jwhitham/towel-rail-system/tr/tr.kicad_pcb

## KiCad design PCB/electrical_integration/motor_driver.kicad_sch

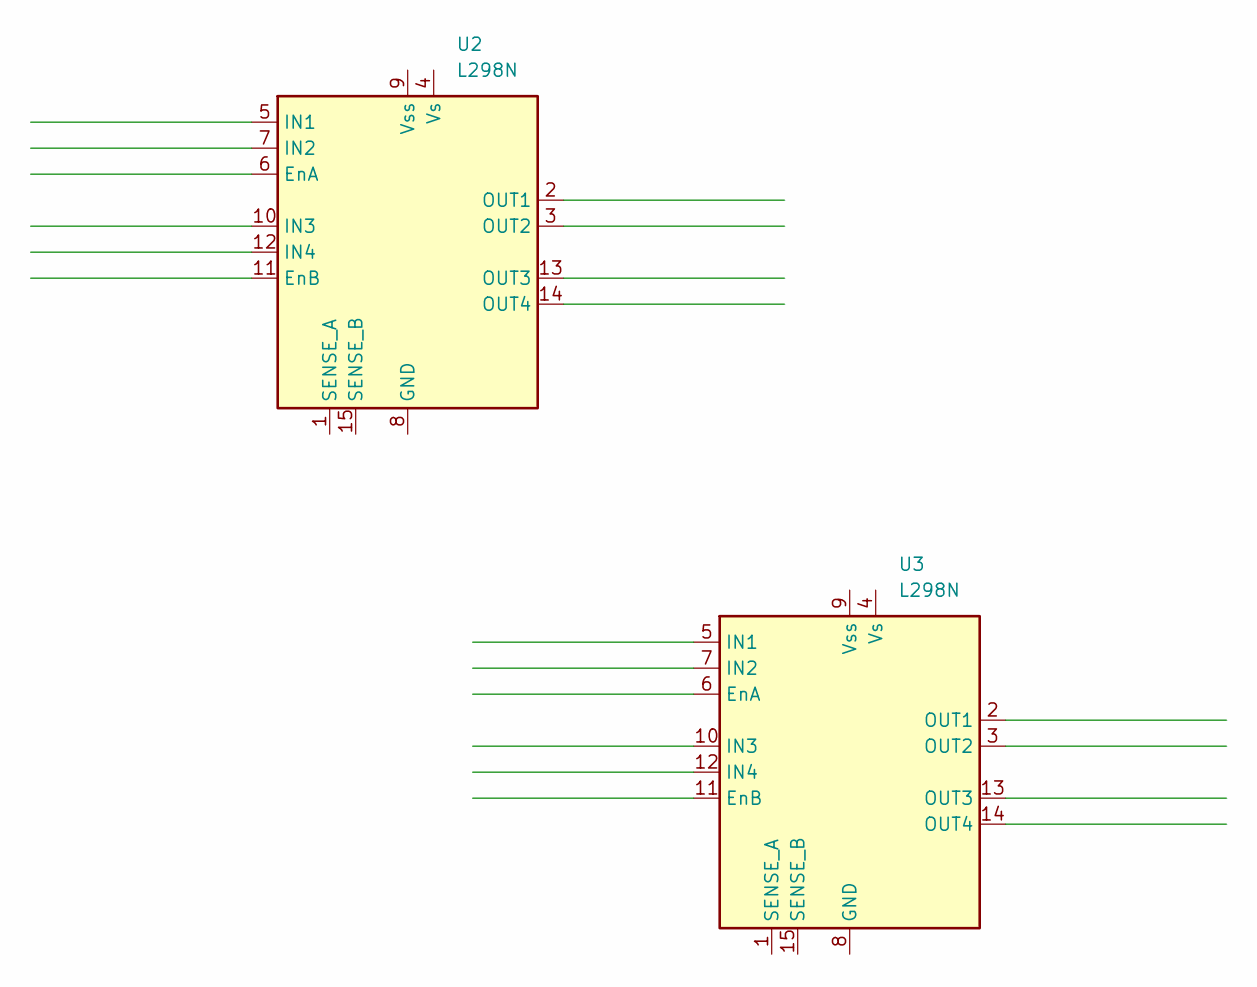
[picture p1: schematic motor_driver.kicad_sch]

Parts:
U2, U3: L298N; TO-220-15_P2.54x5.08mm_StaggerOdd_Lead4.58mm_Vertical
