jwhitham/towel-rail-system/(commit log)

2025-09-13 add kicad project and SVG
    [vs.kicad_pcb, vs.kicad_sch]
2025-10-28 Use a lookup table for temperature values
2025-11-01 Fork ventilation-system project and repurpose for towel-rail
    [vs.kicad_pcb, vs.kicad_sch]
2025-11-02 Add circuit diagram
    [tr.kicad_pcb, tr.kicad_sch]
2025-11-11 Improve temperature and on-time reporting
